frohro/IQ_SDR/Transceiver/IQ_SDR/bom/Parts_to_order.png

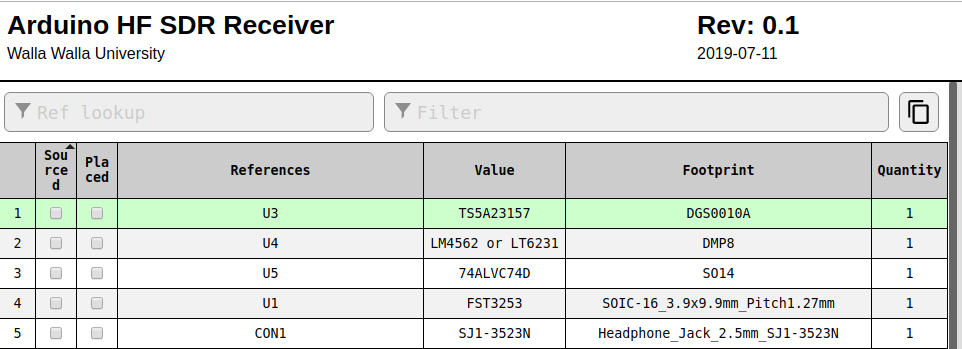
Transceiver/IQ_SDR/bom/Parts_to_order.png
