frohro/IQ_SDR/muSDRx/muSDRx.pdf

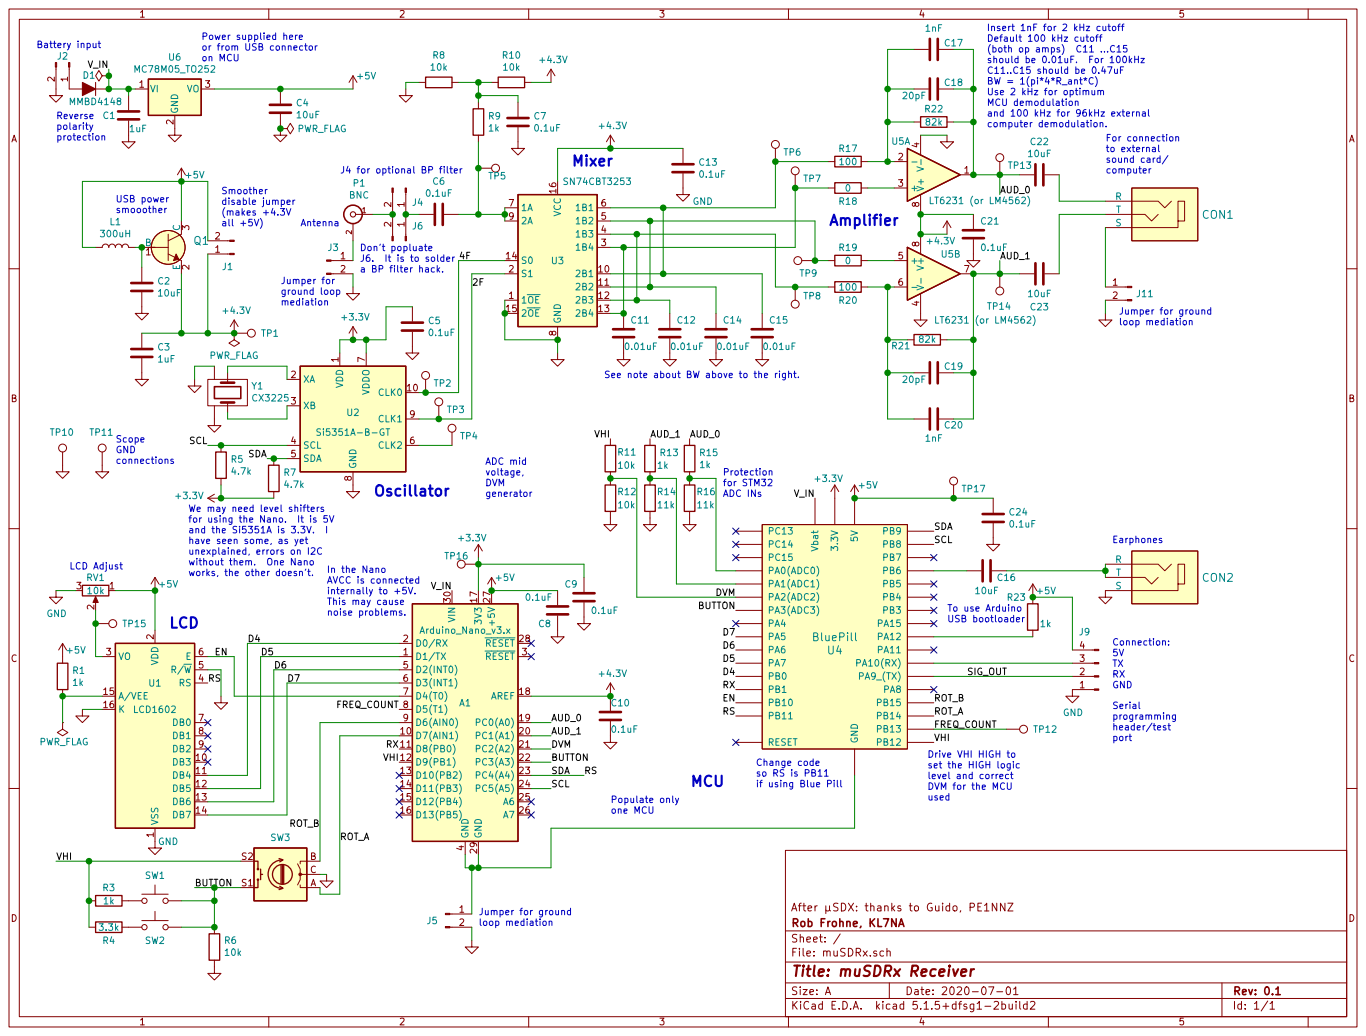
[picture p96: page 1]

Insert 1nF for 2 kHz cutoff Default 100 kHz cutoff (both op amps) C11 ...C15

or from USB connector on MCU

should be 0.01uF. For 100kHz C11..C15 should be 0.47uF BW = 1(pi*4*R_ant*C)

Use 2 kHz for optimum MCU demodulation

J6. It is to solder a BP filter hack. Reverse
polarity

and 100 kHz for 96kHz external computer demodulation.

to external sound card/ computer To use Arduino USB bootloader Mixer

J4 for optional BP filter

1 CLK0 10 XA 2 XB 3 SCL 4 SDA 5 CLK2 6 VDDO

We may need level shifters
for using the Nano. It is 5V and the Si5351A is 3.3V. I have seen some, as yet

In the Nano AVCC is connected

Drive VHI HIGH to set the HIGH logic

Change code so RS is PB11

level and correct DVM for the MCU

if using Blue Pill

After µSDX: thanks to Guido, PE1NNZ
Id: 1/1 Title: muSDRx Receiver File: muSDRx.sch Sheet: / Rob Frohne, KL7NA
