frohro/IQ_SDR/Transceiver/IQ_SDR/IQ_SDR.pdf

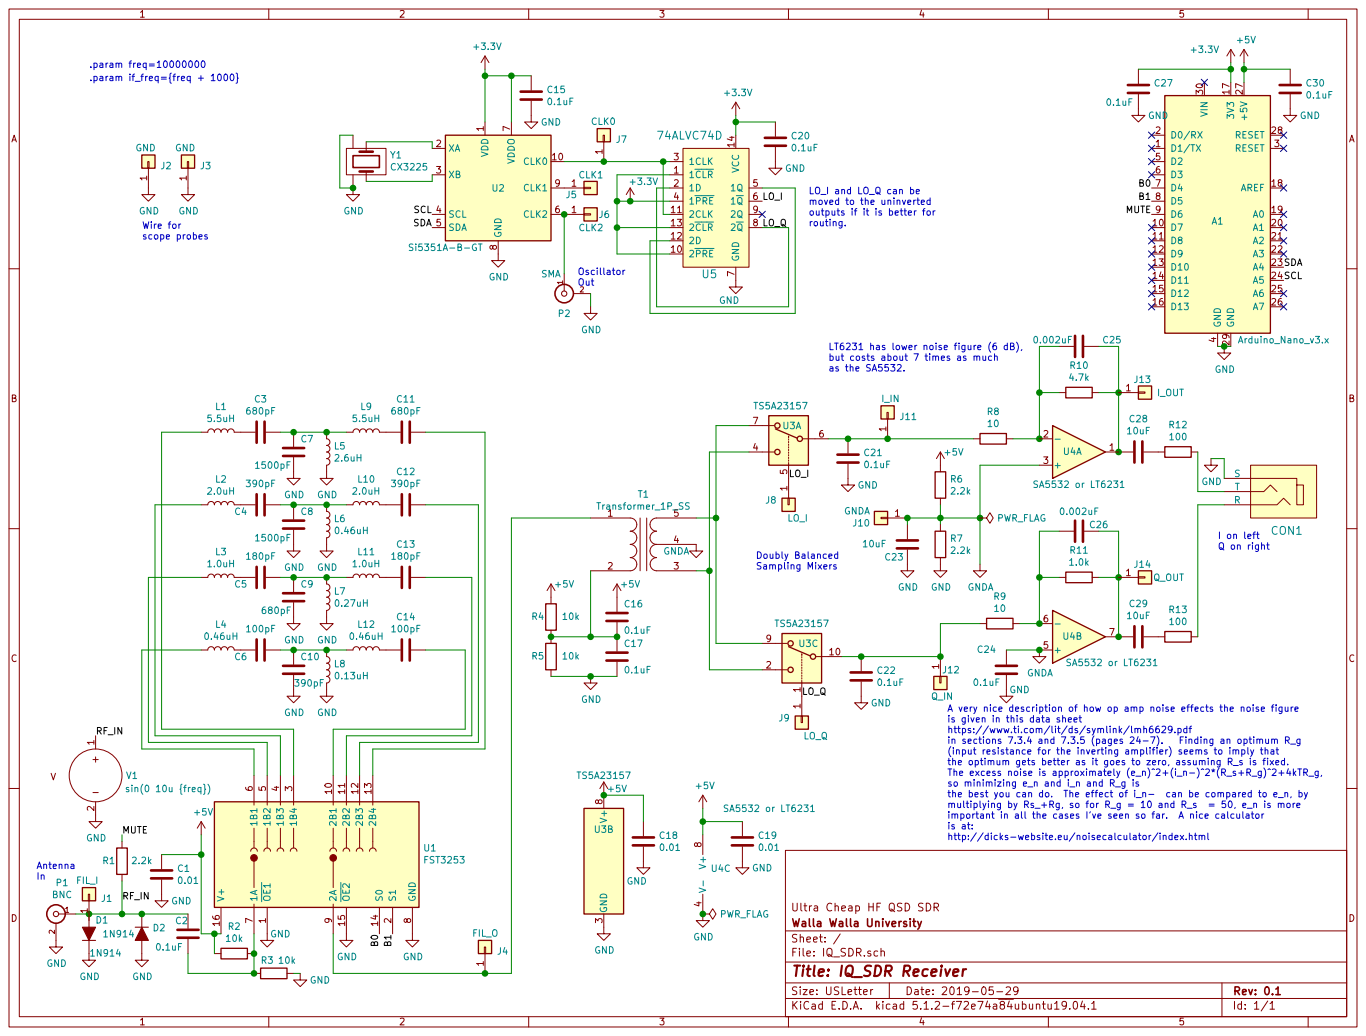
[picture p97: page 1]

8 CLK1 9 U2 Si5351A-B-GT D1/TX 1 D7 10 D8 11 D9 12 D10 13 D11 14 D12 15 D13 16 3V3 17 AREF 18 A0 19 D0/RX 2 A1 20 A2 21 A3 22 A4 23 A5 24 A6 25 A7 26 +5V 27 RESET 28 GND 29 RESET 3 VIN 30 GND

1 CLK0 10 XA 2 XB 3 SCL 4 SDA 5 CLK2 6 VDDO

7 GND
Ultra Cheap HF QSD SDR VDD

LO_I and LO_Q can be moved to the uninverted outputs if it is better for

LT6231 has lower noise figure (6 dB), but costs about 7 times as much

A very nice description of how op amp noise effects the noise figure
is given in this data sheet
https://www.ti.com/lit/ds/symlink/lmh6629.pdf
in sections 7.3.4 and 7.3.5 (pages 24-7). Finding an optimum R_g
(input resistance for the inverting amplifier) seems to imply that
the optimum gets better as it goes to zero, assuming R_s is fixed.
The excess noise is approximately (e_n)^2+(i_n-)^2*(R_s+R_g)^2+4kTR_g,
so minimizing e_n and i_n and R_g is
the best you can do. The effect of i_n- can be compared to e_n, by
multiplying by Rs_+Rg, so for R_g = 10 and R_s = 50, e_n is more
important in all the cases I've seen so far. A nice calculator
is at: http://dicks-website.eu/noisecalculator/index.html

File: IQ_SDR.sch Sheet: / Walla Walla University
