frohro/IQ_SDR/muSDRx/LTSpice Simulations/Draft1.asc

C1: cap; 159.2pF
L1: ind; 10.2nH
R1: res; 50
V1: voltage; ""; AC 2 0; Rser=50
Named nets: 0, Vo
.ac lin 100 90MEG 150MEG
