frohro/IQ_SDR/muSDRx/LTSpice Simulations/Draft2.asc

R1: res; 1k
R2: res; 10k
U1: OP07
V1: voltage; SINE(0 1 1 0 0 0); AC 1 0
V2: voltage; 10
V3: voltage; -10
Named nets: 0, Vo, +VCC, -VCC, +Vcc, -Vcc
.tran 2
