frohro/IQ_SDR/muSDRx/LTSpice Simulations/Draft3.asc

I1: current; SINE(0 1m 1); AC 1m
R1: res; 10k
U1: OP07
V1: voltage; 10
V2: voltage; -10
Named nets: +VCC, -VCC, 0, Vo
;tran 2
.ac dec 100 1 100MEG
