frohro/IQ_SDR/muSDRx/LTSpice Simulations/Smoother.asc

C1: cap; 10µF
L1: ind; 300mH
Q1: npn; 2N2222
R1: res; 0.1
R2: res; 150
V1: voltage; SINE(5 0.5 1000); AC .5 0; Rser=0
Named nets: 0, V_4.3
;ac dec 100 10 10Meg
.op dec 100 10 10Meg
