frohro/IQ_SDR/muSDRx/LTSpice Simulations/Smoother Circuitasc.asc

C1: cap; 10µF
L1: ind; 300mH
Q1: npn; 2N2222
R1: res; 10
R2: res; 0.01
V1: voltage; SINE(5 .1 10000)
Named nets: 0, V_O, VB
;op
.tran 2mS
