frohro/IQ_SDR/Transceiver/LTSpice Simualitons/AC_SDR_IQ.asc

C1: cap; 10µ
C2: cap; 100p
C3: cap; 0.02µ
C4: cap; 390p
C5: cap; 390p
C6: cap; 100p
C7: cap; 100p
C8: cap; 0.02µ
C9: cap; 2000p
C10: cap; 0.02µ
L1: ind2; 13µ
L2: ind2; 13µ
L3: ind2; 54µ
L4: ind; 497n
L5: ind; 497n
L6: ind; 1.98µ
R1: res; 2200
R2: res; 2200
R3: res; 10
R4: res; 2.5k
R5: res; 0.1
R6: res; 0.1
R7: res; 10
R8: res; 2.5k
R9: res; 10
R10: res; 2.5k
R11: res; 15
S1: sw; MYSW
S2: sw; MYSW
S3: sw; MYSW
S4: sw; MYSW
U1: LT6231
U2: LT6231
U3: LT6231
V1: voltage; SINE(0 10 {f} 0 0 0)
V2: voltage; SINE(0 10 {f} 0 0 90)
V3: voltage; SINE(0 10e-6 {f+10000}); AC 2; Rser=50
V4: voltage; 4.3
V5: voltage; SINE(0 10e-6 {10000}); AC 2; Rser=50
Named nets: 0, AGND, I, Q, VCC, V_out
.model MYSW SW(Ron=15 Roff=1Meg Vt=0 Vh=0)
K1 L1 L2 L3 1
.param f=14.0e6
.ac dec 200 1 100e6
