frohro/IQ_SDR/Transceiver/LTSpice Simualitons/attenuator.asc

R1: res
R2: res
R3: res
R4: res
R5: res
R6: res
R7: res
R8: res; 50
V1: voltage
Named nets: 0
