frohro/IQ_SDR/Transceiver/LTSpice Simualitons/Draft1.asc

C1: cap; 0.1e-6
C2: cap; 2200e-12
C3: cap; 0.1e-6
L1: ind2; 2.5e-6
L2: ind2; 2.5e-6
L3: ind2; 10e-6
R1: res; 2200
R2: res; 2200
R3: res; 10
R4: res; 1000
R5: res; 10
S1: sw; MYSW
S2: sw; MYSW
U1: LT6231
V1: voltage; SINE(0 10 {f} 0 0 0)
V2: voltage; SINE(0 10 {f} 0 0 90)
V3: voltage; SINE(0 10e-6 {f+10000}); Rser=50
V4: voltage; 4.3
Named nets: 0, AGND, I, Q, VCC, V_out
;tran 1e-3
.model MYSW SW(Ron=1 Roff=1Meg Vt=0 Vh=0)
K1 L1 L2 L3 1
.param f=14.0e6
;noise V(V_out) V3 dec 10 1e0 30e6
.ac dec 100 1e6 30e6
