frohro/IQ_SDR/Transceiver/LTSpice Simualitons/Noise_SDR_IQ.asc

C1: cap; 10µ
C2: cap; 100p
C3: cap; 0.02µ
C4: cap; 10µ
C5: cap; 10µ
C6: cap; 10µ
D1: diode; 1N914
D2: diode; 1N914
D3: diode; 1N914
D4: diode; 1N914
D5: diode; 1N914
D6: diode; 1N914
D7: diode; 1N914
D8: LED; QTLP690C
L1: ind2; 56µ
L2: ind2; 13µ
Q1: npn; 2N2222
Q2: npn; 2N2222
R1: res; 1k
R2: res; 15
R3: res; 50
R4: res; 13k
R5: res; 1k
R6: res; 700
R7: res; 75k
R9: res; 75k
R10: res; 1k
U1: LT6231
U2: LT6231
U3: LT6231
V4: voltage; 2.15
V5: voltage; SINE(0 10u 10k); Rser=0.001
V6: voltage; 4.3
Named nets: AGND, VCC, 0, V_out, vb, vc3
.ic V(vb)=2.591 V(AGND)=1.923
.noise V(V_out) V5 dec 100 1 1Meg
K1 L1 L2 1
