frohro/IQ_SDR/Transceiver/LTSpice Simualitons/Tran_SDR_IQ.asc

C1: cap; 10µ
C2: cap; 50p
C3: cap; 0.02µ
C4: cap; 390p
C5: cap; 390p
C6: cap; 100p
C7: cap; 50p
C8: cap; 0.02µ
C11: cap; 10µ
C12: cap; 10µ
C13: cap; 10µ
D1: LED; QTLP690C
D2: diode; 1N914
D7: diode; 1N914
D8: diode; 1N914
D9: diode; 1N914
D10: diode; 1N914
D11: diode; 1N914
D12: diode; 1N914
D13: diode; 1N914
L1: ind2; 0.4µH
L2: ind2; 0.4µH
L3: ind2; 6µ
L4: ind; 497n
L6: ind; 1.98µ
L7: ind; 497n
Q2: npn; 2N2222
Q3: npn; 2N2222
R1: res; 2.2k
R2: res; 2.2k
R3: res; 50
R4: res; 13k
R5: res; 0.1
R6: res; 0.1
R7: res; 50
R8: res; 13k
R11: res; 27k
R12: res; 200
R13: res; 47k
S1: sw; MYSW
S2: sw; MYSW
S3: sw; MYSW
S4: sw; MYSW
U1: LT6231
U2: LT6231
V1: voltage; SINE(0 10 {f} 0 0 0)
V2: voltage; SINE(0 10 {f} 0 0 90)
V3: voltage; SINE(0 1e-6 {f+10000}); AC 2; Rser=50
V4: voltage; 2.15
V6: voltage; 4.3
Named nets: 0, AGND, I, Q, VCC, V_out_I, V_out_Q, vb
.tran 0 1.1m 1.0m
.model MYSW SW(Ron=15 Roff=1Meg Vt=0 Vh=0)
K1 L1 L2 L3 1
.param f=14.0e6
.ic V(vb)=2.591 V(AGND)=1.923
