frohro/IQ_SDR/muSDRx/muSDRx.kicad_pcb

## KiCad design muSDRx/muSDRx.kicad_pcb (2022-04-04)

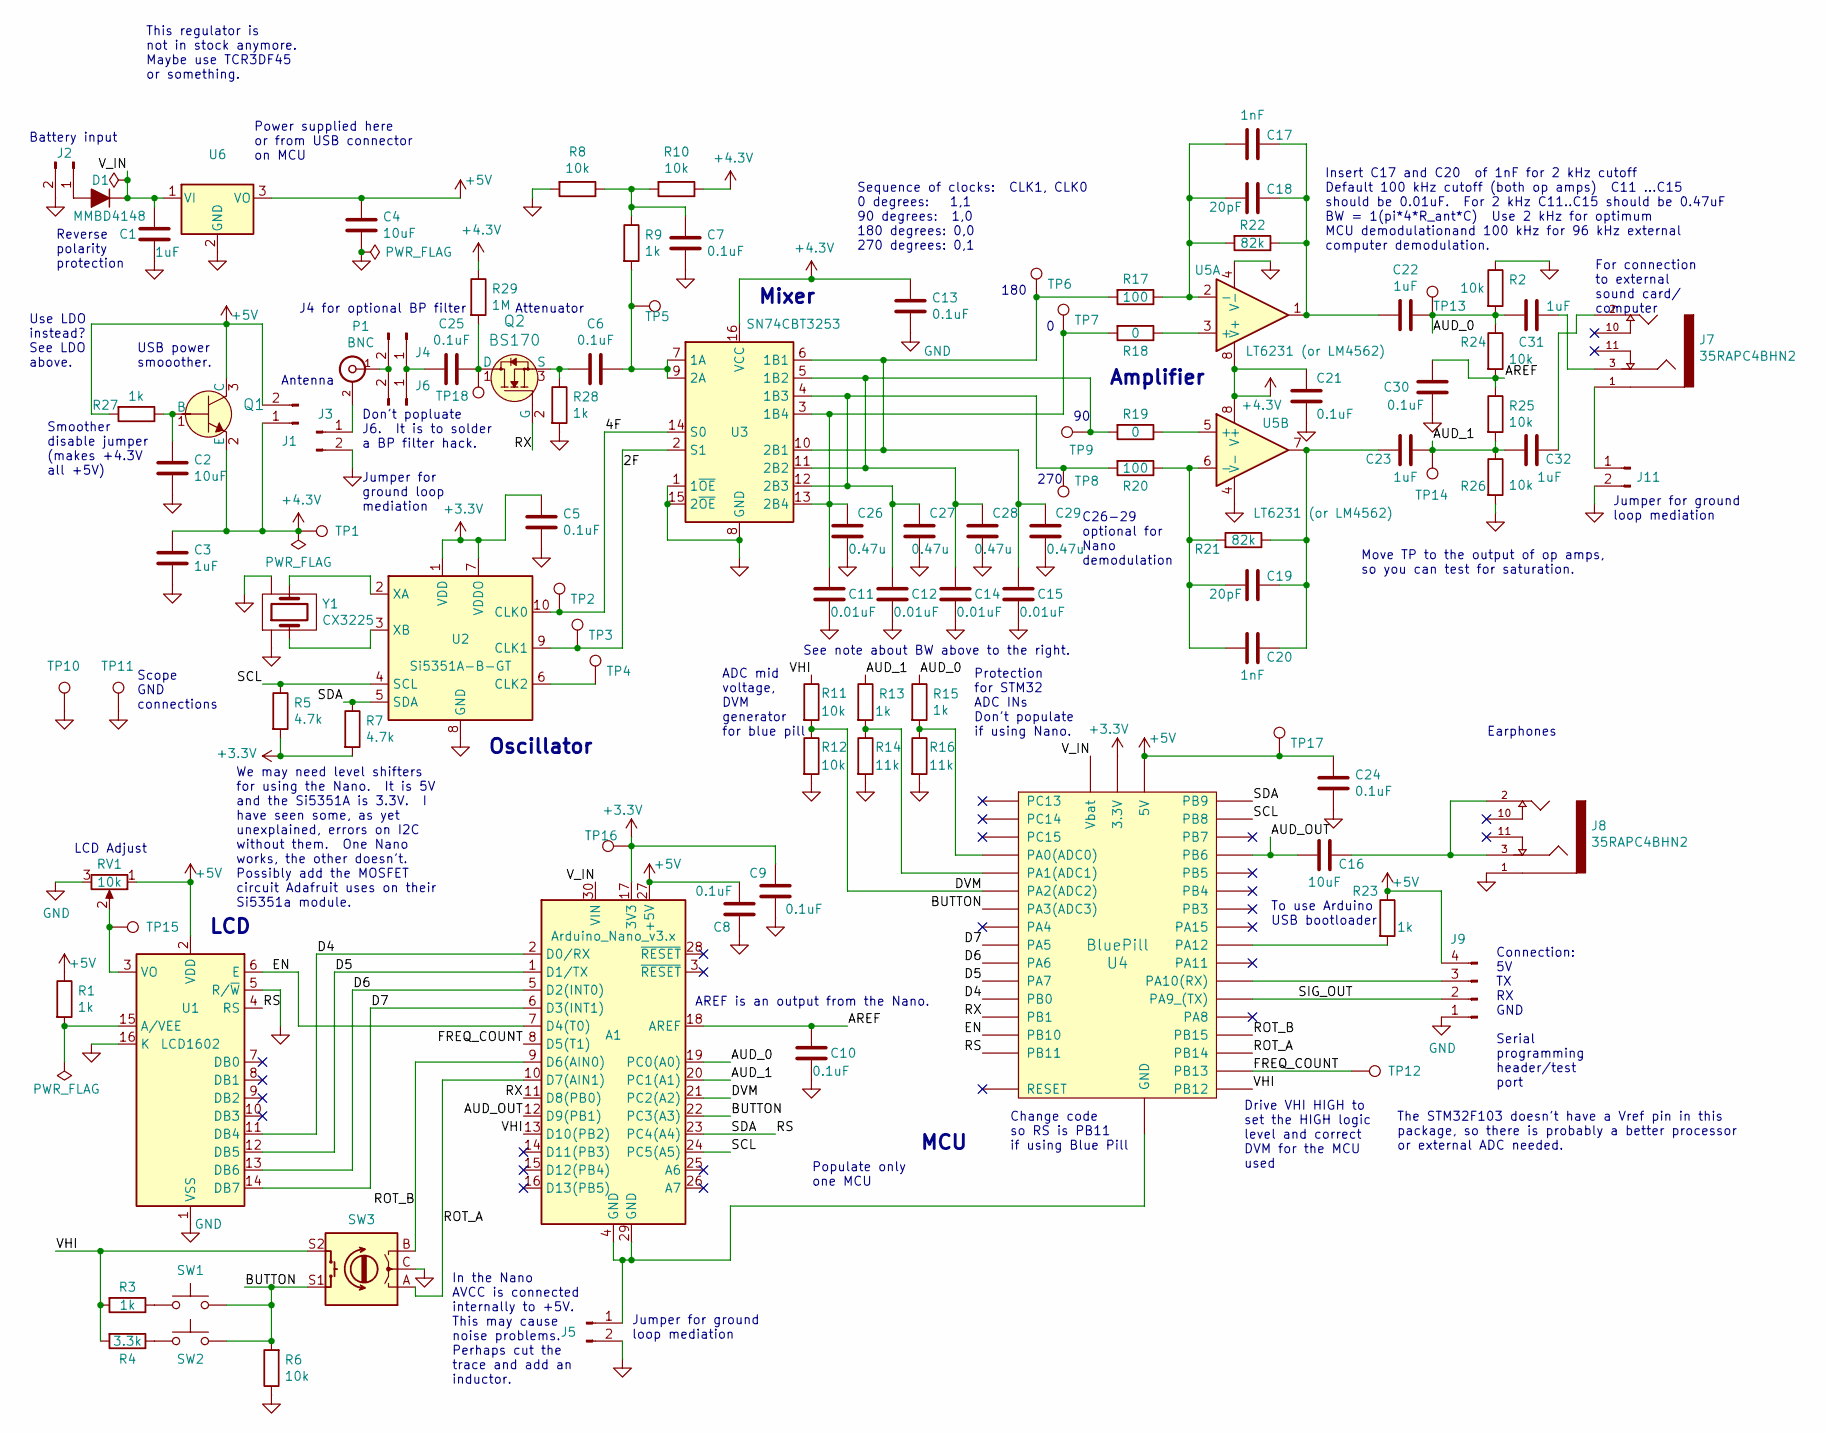
[picture p98: schematic muSDRx.kicad_sch, muSDRx Receiver]

Parts:
A1: Arduino_Nano_v3.x; Arduino_Nano
C1, C3, C22, C23: 1uF; C_0805
C2, C4, C16: 10uF; C_0805
C5, C6, C7, C8, C9, C10, C13, C21, C24: 0.1uF; C_0805
C11, C12, C14, C15: 0.01uF; C_0805
C17, C20: 1nF; C_0805_2012Metric
C18, C19: 20pF; C_0805
C25, C30: 0.1uF; C_0805_2012Metric
C26, C27, C28, C29: 0.47u; C_0805_2012Metric
C31, C32: 1uF; C_0805_2012Metric
D1: MMBD4148; D_SOT-23_ANK
J1, J2, J3, J4, J5, J6, J11: Conn_01x02_Male; Pin_Header_Straight_1x02_Pitch2.54mm
J7, J8: 35RAPC4BHN2; SWITCHCRAFT_35RAPC4BHN2
J9: Conn_01x04_Male; Pin_Header_Straight_1x04_Pitch2.54mm
P1: BNC; BNC_Socket_TYCO-AMP_LargePads
Q1: MMBT2222A-TP; SOT-23-3; MPN MMBT2222A-TP; Digi-Key_PN MMBT2222ATPMSCT-ND
Q2: BS170; TO-92-3; MPN BS170; Digi-Key_PN BS170-ND
R1, R3, R9, R13, R15, R23: 1k; R_0805
R2, R24, R25, R26: 10k; R_0805_2012Metric
R4: 3.3k; R_0805
R5, R7: 4.7k; R_0805
R6, R8, R10, R11, R12: 10k; R_0805
R14, R16: 11k; R_0805
R17, R20: 100; R_0805
R18, R19: 0; R_0805
R21, R22: 82k; R_0805
R27, R28: 1k; R_0805_2012Metric
R29: 1M; R_0805_2012Metric
RV1: 10k; Potentiometer_Trimmer_ACP_CA6h_Vertical
SW1, SW2: SW_Push; SW_PUSH_6mm_h4.3mm
SW3: Rotary_Encoder_Switch; Rotary_Encoder_Switched_PEC11R
TP1, TP2, TP3, TP4, TP5, TP6, TP7, TP8, TP9, TP10, TP11, TP12, TP13, TP14, TP15, TP16, TP17: TestPoint; PINTST
TP18: TestPoint; TestPoint_THTPad_D1.5mm_Drill0.7mm
U1: LCD1602; Pin_Header_Straight_1x16_Pitch2.54mm
U2: Si5351A-B-GT; MSOP-10_3x3mm_Pitch0.5mm
U3: SN74CBT3253; SOIC-16_3.9x9.9mm_Pitch1.27mm
U4: BluePill; BLUEPILL
U5: LT6231 (or LM4562); SOIC-8_3.9x4.9mm_Pitch1.27mm
U6: (no value)
Y1: CX3225; Crystal_SMD_Abracon_ABM8G-4pin_3.2x2.5mm

Connections:
+3V3: A1.17 (3V3), C5.1, C9.1, R5.2, R7.2, TP16.1, U2.1 (VDD), U2.7 (VDDO), U4.3V3 (3.3V)
+4.3V: C3.1, C13.1, C21.1, J1.1, Q1.2 (E), R10.1, R29.1, TP1.1, U3.16 (VCC), U5.8 (V+)
+5V: A1.27 (+5V), C4.1, C8.1, C24.1, J1.2, J9.4, Q1.3 (C), R1.1, R23.1, R27.2, RV1.1, TP17.1, U1.2 (VDD), U4.5V, U6.3 (VO)
/2F: TP3.1, U2.9 (CLK1), U3.2 (S1)
/4F: TP2.1, U2.10 (CLK0), U3.14 (S0)
/AREF: A1.18 (AREF), C10.1, C30.2, R24.2, R25.1
/AUD_0: A1.19 (PC0(A0)), C22.1, C31.1, R2.2, R15.1, R24.1, TP13.1
/AUD_1: A1.20 (PC1(A1)), C23.1, C32.1, R13.1, R25.2, R26.1, TP14.1
/AUD_OUT: A1.12 (D9(PB1)), C16.2, U4.PB6
/BUTTON: A1.22 (PC3(A3)), R6.2, SW1.2, SW2.2, SW3.S1, U4.PA3 (PA3(ADC3))
/D4: A1.2 (D0/RX), U1.11 (DB4), U4.PB0
/D5: A1.1 (D1/TX), U1.12 (DB5), U4.PA7
/D6: A1.5 (D2(INT0)), U1.13 (DB6), U4.PA6
/D7: A1.6 (D3(INT1)), U1.14 (DB7), U4.PA5
/DVM: A1.21 (PC2(A2)), R11.2, R12.1, U4.PA2 (PA2(ADC2))
/EN: A1.7 (D4(T0)), U1.6 (E), U4.PB10
/FREQ_COUNT: A1.8 (D5(T1)), TP12.1, U4.PB13
/ROT_A: A1.10 (D7(AIN1)), SW3.A, U4.PB14
/ROT_B: A1.9 (D6(AIN0)), SW3.B, U4.PB15
/RS: A1.23 (PC4(A4)), R7.1, U1.4 (RS), U2.5 (SDA), U4.PB9, U4.PB11
/RX: A1.11 (D8(PB0)), Q2.2 (G), U4.PB1
/SCL: A1.24 (PC5(A5)), R5.1, U2.4 (SCL), U4.PB8
/SIG_OUT: J9.2, U4.PA9 (PA9_(TX))
/VHI: A1.13 (D10(PB2)), R3.2, R4.2, R11.1, SW3.S2, U4.PB12
/V_IN: A1.30 (VIN), C1.1, D1.3 (K), U4.VBAT (Vbat), U6.1 (VI)
GND: C1.2, C2.2, C3.2, C4.2, C5.2, C7.2, C8.2, C9.2, C10.2, C11.2, C12.2, C13.2, C14.2, C15.2, C21.2, C24.2, C26.2, C27.2, C28.2, C29.2, C30.1, J2.2, J3.2, J5.2, J8.1, J9.1, J11.2, R2.1, R6.1, R8.2, R12.2, R14.2, R16.2, R26.2, R28.2, RV1.3, SW3.C, TP10.1, TP11.1, U1.1 (VSS), U1.5 (R/~W), U1.16 (K), U2.8 (GND), U3.1 (1~OE), U3.8 (GND), U3.15 (2~OE), U5.4 (V-), U6.2 (GND), Y1.2 (GND), Y1.4 (GND); also elsewhere on the board
unnamed: A1.4 (GND), A1.29 (GND), J5.1, U4.G (GND)
unnamed: C2.1, Q1.1 (B), R27.1
unnamed: C6.1, R9.2, TP5.1, U3.7 (1A), U3.9 (2A)
unnamed: C6.2, Q2.3 (S), R28.1
unnamed: C7.1, R8.1, R9.1, R10.2
unnamed: C11.1, C26.1, R18.2, TP7.1, U3.3 (1B4), U3.13 (2B4)
unnamed: C12.1, C27.1, R20.2, TP8.1, U3.4 (1B3), U3.12 (2B3)
unnamed: C14.1, C28.1, R19.2, TP9.1, U3.5 (1B2), U3.11 (2B2)
unnamed: C15.1, C29.1, R17.2, TP6.1, U3.6 (1B1), U3.10 (2B1)
unnamed 35: C16.1, J8.2, J8.3; also elsewhere on the board
unnamed: C17.1, C18.1, C22.2, R22.1, U5.1
unnamed: C17.2, C18.2, R17.1, R22.2, U5.2 (-)
unnamed: C19.1, C20.1, C23.2, R21.1, U5.7
unnamed: C19.2, C20.2, R20.1, R21.2, U5.6 (-)
unnamed: C25.1, Q2.1 (D), R29.2, TP18.1
unnamed: C25.2, J4.1, J6.1
unnamed 42: C31.2, J7.3; also elsewhere on the board
unnamed 43: C32.2, J7.2; also elsewhere on the board
unnamed 44: J7.1, J11.1; also elsewhere on the board
unnamed: D1.1 (A), J2.1
unnamed: J3.1, P1.2 (Ext)
unnamed: J4.2, J6.2, P1.1 (In)
unnamed: J9.3, U4.PA10 (PA10(RX))
unnamed: R1.2, U1.15 (A/VEE)
unnamed: R3.1, SW1.1
unnamed: R4.1, SW2.1
unnamed: R13.2, R14.1, U4.PA1 (PA1(ADC1))
unnamed: R15.2, R16.1, U4.PA0 (PA0(ADC0))
unnamed: R18.1, U5.3 (+)
unnamed: R19.1, U5.5 (+)
unnamed: R23.2, U4.PA12
unnamed: RV1.2, TP15.1, U1.3 (VO)
unnamed: TP4.1, U2.6 (CLK2)
unnamed: U2.2 (XA), Y1.3 (2)
unnamed: U2.3 (XB), Y1.1

Notes on the sheet:
Power supplied here or from USB connector on MCU
Jumper for ground loop mediation
Reverse polarity protection
J4 for optional BP filter
Scope GND connections
Earphones
ADC mid voltage, DVM generator for blue pill
180
Populate only one MCU
Serial programming header/test port
C26-29 optional for Nano demodulation
Attenuator
Don't popluate J6. It is to solder a BP filter hack.
Mixer
Battery input
Amplifier
270
Jumper for ground loop mediation
USB power smooother.
Change code so RS is PB11 if using Blue Pill
Sequence of clocks: CLK1, CLK0 0 degrees: 1,1 90 degrees: 1,0 180 degrees: 0,0 270 degrees: 0,1
Use LDO instead? See LDO above.
Antenna
For connection to external sound card/ computer
See note about BW above to the right.
This regulator is not in stock anymore. Maybe use TCR3DF45 or something.
Move TP to the output of op amps, so you can test for saturation.
LCD
In the Nano AVCC is connected internally to +5V. This may cause noise problems. Perhaps cut the trace and add an inductor.
To use Arduino USB bootloader
Smoother disable jumper (makes +4.3V all +5V)
The STM32F103 doesn't have a Vref pin in this package, so there is probably a better processor or external ADC needed.
Protection for STM32 ADC INs Don't populate if using Nano.
AREF is an output from the Nano.
Insert C17 and C20 of 1nF for 2 kHz cutoff Default 100 kHz cutoff (both op amps) C11 ...C15 should be 0.01uF. For 2 kHz C11..C15 should be 0.47uF BW = 1(pi*4*R_ant*C) Use 2 kHz for optimum MCU demodulationand 100 kHz for 96 kHz external computer demodulation.
MCU
Oscillator
Drive VHI HIGH to set the HIGH logic level and correct DVM for the MCU used
We may need level shifters for using the Nano. It is 5V and the Si5351A is 3.3V. I have seen some, as yet unexplained, errors on I2C without them. One Nano works, the other doesn't. Possibly add the MOSFET circuit Adafruit uses on their Si5351a module.
LCD Adjust
Connection: 5V TX RX GND

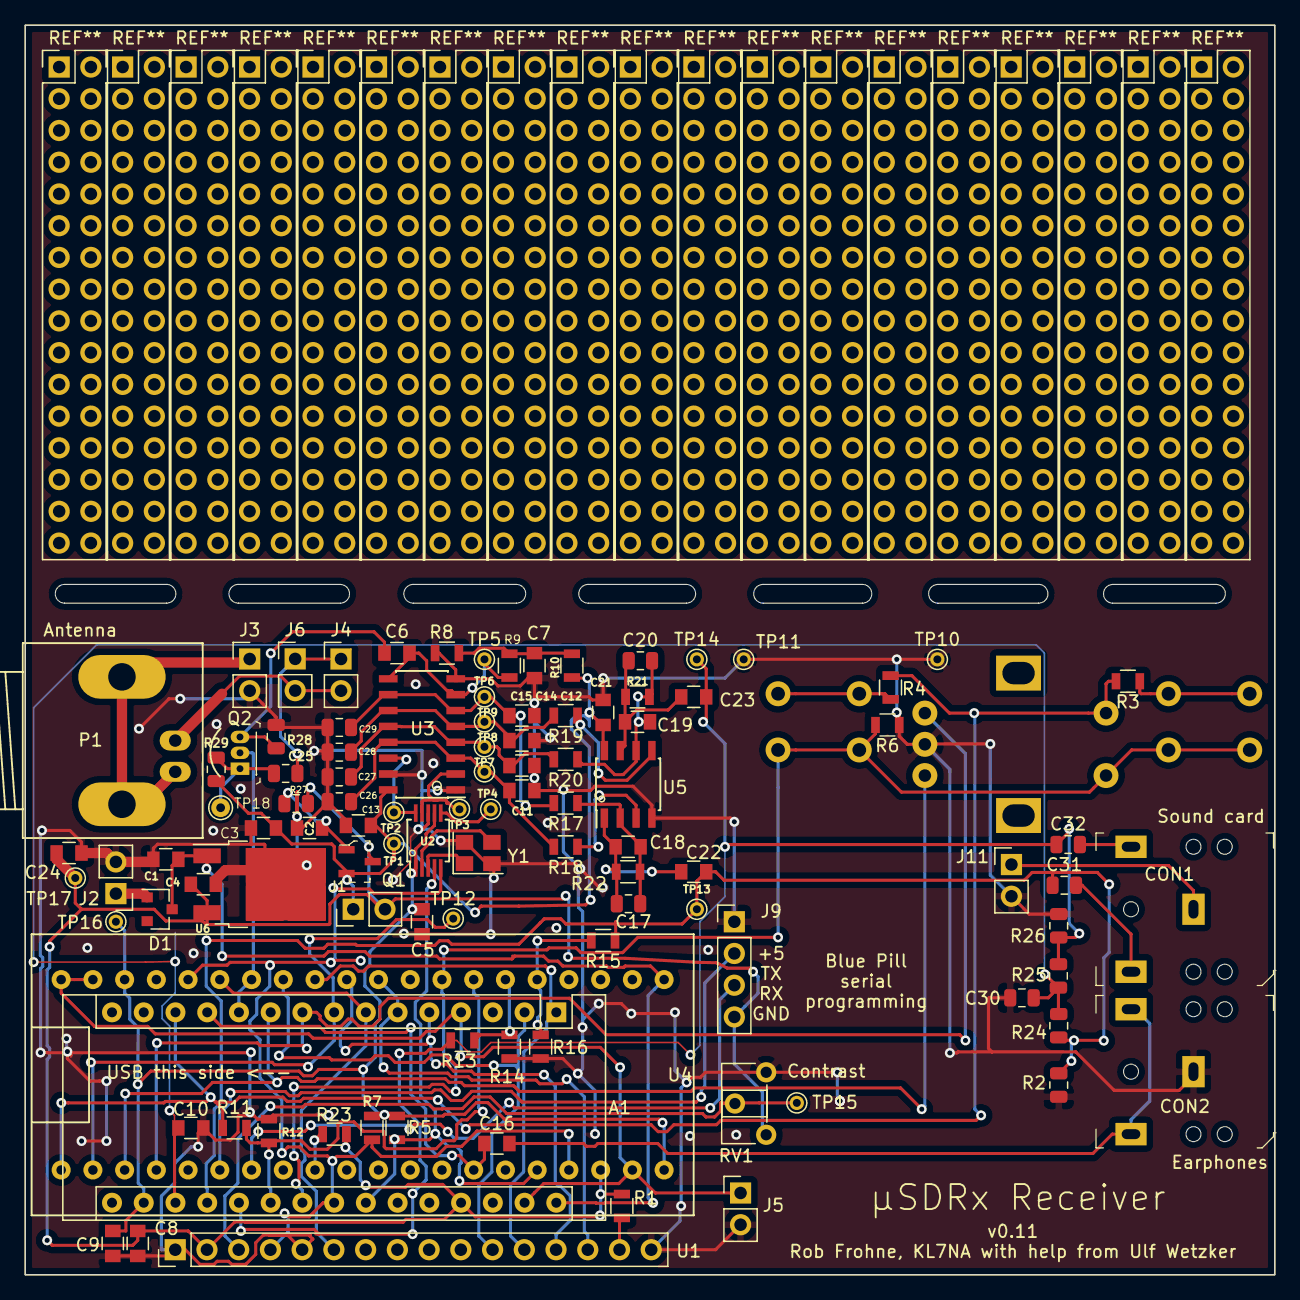
[picture p99: board muSDRx.kicad_pcb from above]

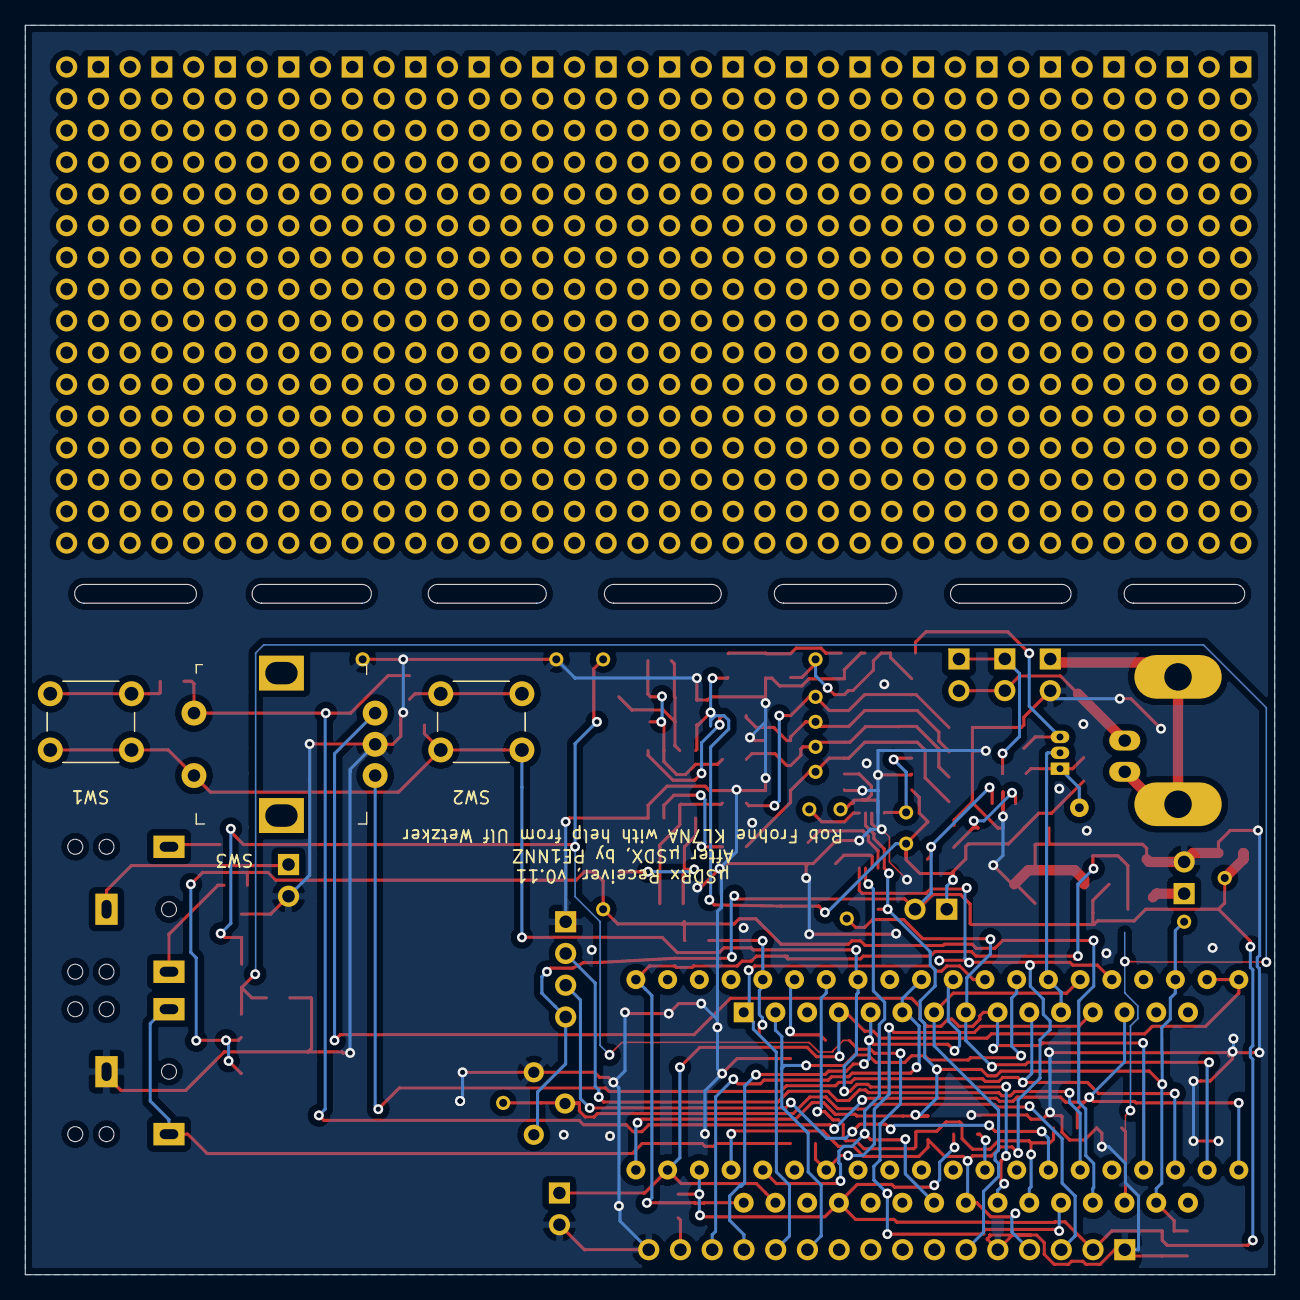
[picture p100: board muSDRx.kicad_pcb from below]

Board: 2 copper layers, 100.0 x 100.0 mm, 105 parts (3 on the bottom side), 61 nets.

Other parts of the board:
CON1, CON2: SJ1-3523N; Headphone_Jack_2.5mm_SJ1-3523N

Their connections:
GND: CON2.1; also elsewhere on the board
unnamed 35: CON2.2, CON2.3; also elsewhere on the board
unnamed 42: CON1.3; also elsewhere on the board
unnamed 43: CON1.2; also elsewhere on the board
unnamed 44: CON1.1; also elsewhere on the board
