frohro/IQ_SDR/Receiver/IQ_SDR/IQ_SDR.sch

## KiCad design Receiver/IQ_SDR/IQ_SDR.sch (2019-12-30)

Schematic: IQ_SDR.sch

Parts:
A1: Arduino_Nano_v3.x; Arduino_Nano
C1, C18, C19: 0.01; C_0805
C2, C13: 820pF; C_0805
C3, C15, C16, C17, C20, C21, C22, C25, C28, C32: 0.1uF; C_0805
C4, C14: 1.5nF; C_0805
C5, C11: 220pF; C_0805
C6, C12: 390pF; C_0805
C7: 47pF; C_0805
C8: 100pF; C_0805
C9: 180pF; C_0805
C10: 470pF; C_0805
C23, C24, C29, C30, C31: 10uF; C_0805
C26, C27: 2200pF; C_0805
CON1: SJ1-3523N; Headphone_Jack_2.5mm_SJ1-3523N; MPN SJ1-3523N; Digi-Key_PN CP1-3523N-ND
D1, D2: 1N914; D_SOD-323
J1: ANT; PINTST
J2, J4: GND; PINTST
J3: V_IN pin header; Pin_Header_Straight_1x02_Pitch2.54mm
J5: V_IN; BARREL_JACK
J6: FIL_O; PINTST
J7: CLK1; PINTST
J8: CLK2; PINTST
J9: CLK0; PINTST
J10: LO_I; PINTST
J11: LO_Q; PINTST
J12: GNDA; PINTST
J13: I_IN; PINTST
J14: Q_IN; PINTST
J15: +5V; PINTST
J16: 4.3V; PINTST
J17: I_OUT; PINTST
J18: Q_OUT; PINTST
J19, J20: Conn_01x01_Male; Pin_Header_Straight_1x01_Pitch2.54mm
JP1: smooth disable; Pin_Header_Straight_1x02_Pitch2.54mm
JP2: Jumper_3_Bridged12; Pin_Header_Straight_1x03_Pitch2.54mm
L1, L11: 1uH; L_Toroid_Vertical_L10.0mm_W5.0mm_P5.08mm
L2, L12: 2.4uH; L_Toroid_Vertical_L10.0mm_W5.0mm_P5.08mm
L3, L9: 232nH; L_Toroid_Vertical_L10.0mm_W5.0mm_P5.08mm
L4, L10: 497nH; L_Toroid_Vertical_L10.0mm_W5.0mm_P5.08mm
L5: 1.137uH; L_Toroid_Vertical_L10.0mm_W5.0mm_P5.08mm
L6: 1.98uH; L_Toroid_Vertical_L10.0mm_W5.0mm_P5.08mm
L7: 4uH; L_Toroid_Vertical_L10.0mm_W5.0mm_P5.08mm
L8: 7.2uH; L_Toroid_Vertical_L10.0mm_W5.0mm_P5.08mm
P1: BNC; BNC_Socket_TYCO-AMP_LargePads
P2: SMA; SMA_EDGE
Q1: MMBT2222A-TP; SOT-23-3; MPN MMBT2222A-TP; Digi-Key_PN MMBT2222ATPMSCT-ND
R1, R6, R7: 2.2k; R_0805
R2, R4: 10k; R_0805
R3, R5: 5.6k; R_0805
R8: 1k; R_0805
R9, R10: 10; R_0805
R11, R12: 1.0k; R_0805
R13, R14: 100; R_0805
R15, R16: 4.7k; R_0805
T1: Transformer_1P_SS; 4_to_1_Transmission_Line_TransformerTHT
U1: FST3253 or TS3A5017; TSSOP-16_4.4x5mm_Pitch0.65mm
U2: Si5351A-B-GT; MSOP-10
U3: TS5A23157; DGS0010A
U4: LM4562 or LT6231; SOIC-8_3.9x4.9mm_Pitch1.27mm
U5: 74ALVC74D; SO14; MPN SN74HC74N; Digi-Key_PN 1727-6097-ND
V1: sin(0 10u {freq})
Y1: CX3225; Crystal_SMD_Abracon_ABM8G-4pin_3.2x2.5mm

Notes on the sheet:
Doubly Balanced Sampling Mixers
.param freq=10000000
.param if_freq={freq + 1000}
LO_I and LO_Q can be moved to the uninverted outputs if it is better for routing.
I on left Q on right
A very nice description of how op amp noise effects the noise figure is given in this data sheet https://www.ti.com/lit/ds/symlink/lmh6629.pdf in sections 7.3.4 and 7.3.5 (pages 24-7). Finding an optimum R_g (input resistance for the inverting amplifier) seems to imply that the optimum gets better 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
LT6231 has lower noise figure (4.7 dB), but costs about 7 times as much as the SA5532. LME49860 is intermediate option. LM4562 could be even better (10.6 dB) 2.7nV/sqrt(Hz).
Antenna In
Oscillator Out
Wire for scope probes
V_IN is an optional DC Voltage for up to +30V.
Emitter follower to smooth USB +5V.
External DC in to run op amps if desired.
Inputs for external DC input for op amps.
R9-10 can be up to 100 with LM4562.
Making T1 a step up transformer makes the S/N and NF better, but op amp input, It is set up for 2:1:1 with 10 Ohms. sampling capacitor, need to be adjusted.
BPF Responses: 1.8MHz-4MHz 4MHz-8MHz 8MHz-16MHz 16MHz-30MHZ
We could use differential amplifiers to eliminate T1. (Switch the mixer chips around.)
Note: switches start at 1, not 0, so 00 => 1 and 01=>2, etc.
Maybe change these diodes to LEDs.
PO74G74A would be faster for the divider.
MASWSS0136 or SN74CBT3257 might be better for mixers.
PO3B14A might be better for Tayloe mixer.
Inductors need to go to 1.5VDC in BPF instead of GND.
C22 and C23 are too big.
Input impedance was maybe 10 Ohms. Make R9-R12 five times larger, 50 Ohms and 5k. C26-C27 should be 1/5 the size.
