frohro/IQ_SDR/Quisk/uSDR-pico/command.h

#ifndef __COMMAND_H__
#define __COMMAND_H__
/* 
 * Command.h
 *
 * Created: 6/2022
 * Author: Rob Frohne
 *
 * See command.c for more information 
 */

void command_get(void);
int parseCommand(char* input);

#endif
