frohro/IQ_SDR/Transceiver/IQ_SDR_Quisk_Blue_Pill/ring_buffer.cpp

/*
   Ring Buffer Functions.
   Copied from the Arduino HardwareSerial libs.
   Copyright (c) 2006 Nicholas Zambetti.  All right reserved.	

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
   For a full copy of the GNU Lesser General Public License, 
   see <http://www.gnu.org/licenses/>.
*/

#include "ring_buffer.h"

void store_char(unsigned char c, struct ring_buffer *buffer)
{
  int i = (unsigned int)(buffer->head + 1) % TX_BUFFER_SIZE;

  // if we should be storing the received character into the location
  // just before the tail (meaning that the head would advance to the
  // current location of the tail), we're about to overflow the buffer
  // and so we don't write the character or advance the head.
  if (i != buffer->tail) {
    buffer->buffer[buffer->head] = c;
    buffer->head = i;
  }
}

unsigned char read_char(struct ring_buffer *buffer){
  // if the head isn't ahead of the tail, we don't have any characters
  if (buffer->head == buffer->tail) {
    return 0;
  } else {
    unsigned char c = buffer->buffer[buffer->tail];
    buffer->tail = (unsigned int)(buffer->tail + 1) % TX_BUFFER_SIZE;
    return c;
  }
}

unsigned int data_waiting(struct ring_buffer *buffer){
    return (unsigned int)(TX_BUFFER_SIZE + buffer->head - buffer->tail) % TX_BUFFER_SIZE;
}
