frohro/IQ_SDR/Quisk/Arduino/SDR_Test1/SDR_Test1.ino

#include "si5351.h"
#include "Wire.h"

Si5351 si5351;

void setup()
{
  bool i2c_found;
  i2c_found = si5351.init(SI5351_CRYSTAL_LOAD_8PF, 0, 0);
  si5351.set_freq(1400000000ULL, SI5351_CLK0);
  Serial.begin(57600);
}


void loop()
{
  si5351.update_status();
  Serial.print("SYS_INIT: ");
  Serial.print(si5351.dev_status.SYS_INIT);
  Serial.print("  LOL_A: ");
  Serial.print(si5351.dev_status.LOL_A);
  Serial.print("  LOL_B: ");
  Serial.print(si5351.dev_status.LOL_B);
  Serial.print("  LOS: ");
  Serial.print(si5351.dev_status.LOS);
  Serial.print("  REVID: ");
  Serial.println(si5351.dev_status.REVID);
}
