frohro/IQ_SDR/(commit log)

2019-06-06 First commit.
    [IQ_SDR.kicad_pcb, IQ_SDR.sch]
2019-06-07 Fixed schematic issues in Receiver and Transceiver
    [IQ_SDR.kicad_pcb, IQ_SDR.sch]
2019-06-27 Started PI filters.
    [IQ_SDR.sch]
2019-06-28 A little clean up on the schematic
    [IQ_SDR.sch]
2019-06-28 More cleanup of schematic
    [IQ_SDR.sch]
2019-07-05 Changes to power and perhaps a better op amp...
    [IQ_SDR.sch]
2019-07-12 Added PCB.
    [IQ_SDR.kicad_pcb, IQ_SDR.sch]
2019-07-12 ...added the other new kicad files.
2019-09-08 Add inductor/transformer details. Change U1 package type. (Maybe should change the IC as we did in rev 0.1.)
    [IQ_SDR.kicad_pcb, IQ_SDR.sch]
2019-12-15 Added torroid data.
    [IQ_SDR.sch]
2019-12-17 saving changes so I can merge from hamshack.
    [IQ_SDR.sch]
2019-12-17 A few more schematic notes from shop.
    [IQ_SDR.sch]
2019-12-17 Added in changes from the shop after failed merge.
    [IQ_SDR.sch]
2019-12-17 Fixes to band pass filters, and notes to help with software.
    [IQ_SDR.sch]
2019-12-26 added rescue libs
    [IQ_SDR.sch]
2019-12-30 Added notes to schematic about impedance matching.
    [IQ_SDR.sch]
2020-03-23 Fixed R9-R12 and C26 and C26-C27 values
    [IQ_SDR.sch]
2020-03-25 Added a note of two things to fix
    [IQ_SDR.sch]
2020-03-29 Added Cern OHL
    [IQ_SDR.kicad_pcb, IQ_SDR.sch]
2020-04-10 Some errors in the bandpass filters and other places corrected to improve the sensitivity and ground loop noise.
    [IQ_SDR.sch]
2020-04-16 Added the LTSpice simulations and started on v0.20 changes.
    [IQ_SDR.sch]
2020-04-20 Fixed some simulation file errors, especially with the noise simulation.
    [IQ_SDR.sch]
2020-04-20 rm'ed an unused filter design report
2020-04-20 added better voltage reference for the op amps
    [IQ_SDR.sch]
2020-04-21 Schematic changes
    [IQ_SDR.sch]
2020-04-23 Moved the transceiver schematic from Reciever to Transceiver
    [IQ_SDR.kicad_pcb, IQ_SDR.sch]
2020-04-23 Added a few files that were needed for the Kicad in Transceiver
2020-04-24 Schematic modifications for transceiver
2020-04-24 Further change to schematic and moving simulations
    [IQ_SDR.kicad_pcb, IQ_SDR.sch]
2020-04-26 PCB initial design
    [IQ_SDR.kicad_pcb, IQ_SDR.sch]
2020-04-30 More edits to the PCB
    [IQ_SDR.kicad_pcb]
2020-04-30 Added arduino stuff
2020-05-07 Commit so I can change branches.
    [IQ_SDR.sch]
2020-05-07 Added the SDR_Test1 testing program for the Arduino.
2020-05-14 update in libraries for schematic
    [IQ_SDR.sch]
2020-06-03 Changes after build, mostly with wrong footprints for parts on hand.
    [IQ_SDR.kicad_pcb, IQ_SDR.sch]
2020-06-16 Modified Arduino code for STM32F103C8 (Blue Pill)
2020-07-03 First commit of muSDR receiver
    [muSDR.kicad_pcb, muSDR.sch]
2020-07-06 Added U6, finished smoother, tried to fix digikey-kicad-library submodule.
    [IQ_SDR.sch, muSDR.sch]
2020-07-06 Added another pair of holes for a band pass filter hack.
    [muSDR.sch]
2020-07-06 finished footprints and schematic "done"
    [muSDR.sch]
2020-07-07 Fixed several footprints, and started placing parts....
    [muSDR.kicad_pcb, muSDR.sch]
2020-07-08 Routed PCB for v0.1.
    [muSDR.kicad_pcb, muSDR.sch, muSDRx.kicad_pcb, muSDRx.sch]
2020-07-13 Added libraries needed....
    [muSDRx.sch]
2020-07-30 Added notes and C11-C15 value changes.
    [muSDRx.kicad_pcb, muSDRx.sch]
2020-07-31 changed docs for regulator on schematic
    [muSDRx.sch]
2020-08-04 Changed R18 and R19 to 0 Ohms for better noise performance at the sacrifice of a little DC offset from input bias currents
    [muSDRx.sch]
2020-08-11 Changed the sampling capacitors to 0.01uF for more bandwidth.
    [IQ_SDR.sch, muSDRx.sch]
2020-08-11 Updated the pdf of the schematic.
2020-09-04 Committing to change to another branch
    [muSDRx.sch]
2021-04-15 Added v0.11 which fixed problems wit stand alone using Nano
    [muSDRx.kicad_pcb, muSDRx.sch]
2021-04-28 Fixed 3.5mm jack footprints so switched ones will work.
    [muSDRx.kicad_pcb, muSDRx.sch]
2021-06-03 Added a few prerequisites for building the Arduino code
2021-06-07 Removed bogus frequency error in quisk_conf_openradio.py
    [quisk_conf_openradio.py]
2022-04-04 So I could change branches.
    [muSDRx.kicad_pcb, muSDRx.sch]
2022-05-15 Added raspberry pi pico support and quadrature in Si5351
2022-05-16 Added muSDR into the repo. Some notes for changes in the schematic.
    [muSDRx-B_Cu.gbr, muSDRx-B_Mask.gbr, muSDRx-B_Paste.gbr, muSDRx-B_SilkS.gbr, muSDRx-Edge_Cuts.gbr, muSDRx-F_Cu.gbr, muSDRx-F_Mask.gbr, muSDRx-F_Paste.gbr]
2022-05-17 Added frequency correction to New_Quisk_Pico.ino
    [New_Quisk_Pico.ino]
2022-05-17 Fixed frequency correction bugs.
    [New_Quisk_Pico.ino]
2022-05-21 Fixed a bug for USE_JOHNSON_COUNTER radios (update Si5351 Etherkit library to version 2)
    [New_Quisk_Pico.ino]
2022-06-10 Added Raspberry Pi Pico support using uSDR-pico since there were problems with the Etherkit si5351 library.
2022-06-22 Tried to add uSDR-pico.
